NNeveur/MultiAntennaControler/AntHubRelayModule.pdf

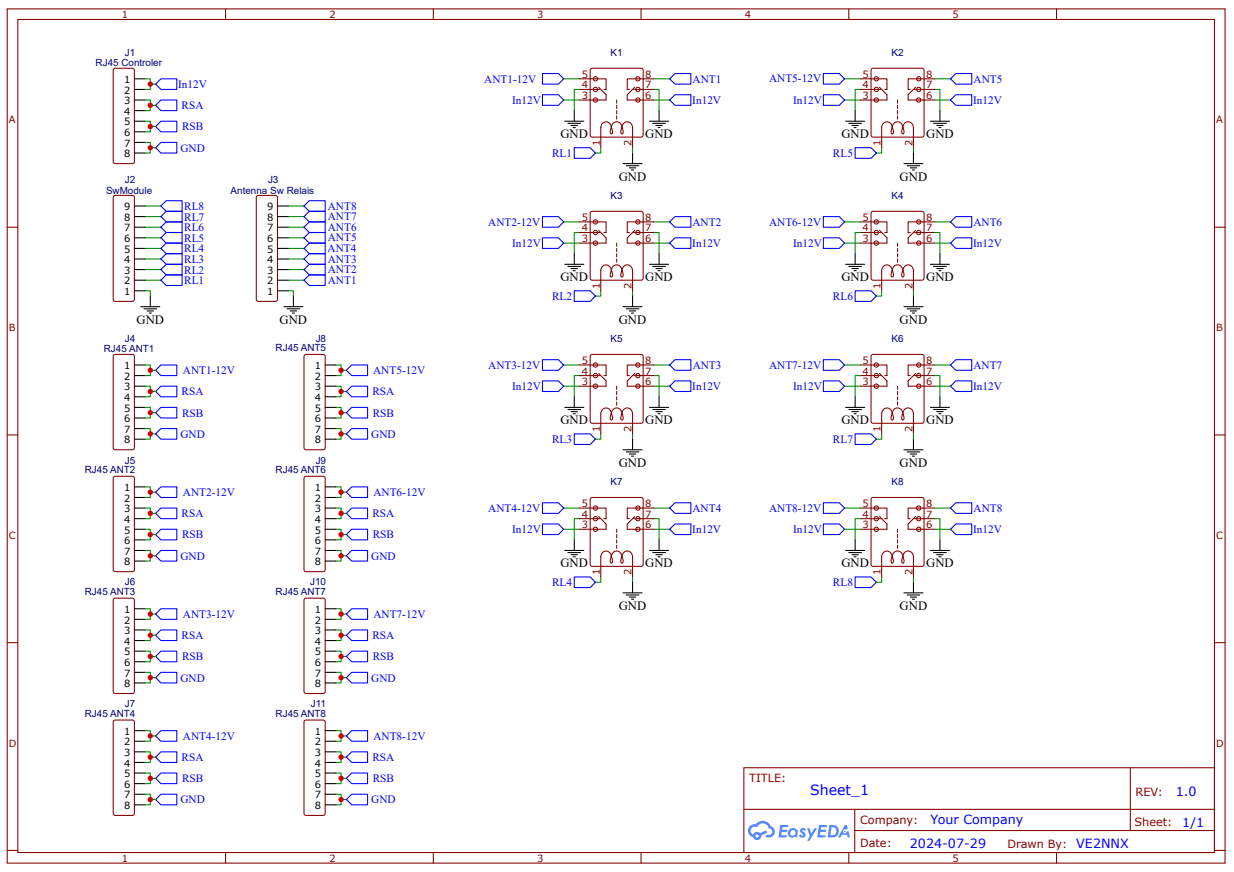
[picture p1: page 1]
TITLE:; REV: 1.0; Date:; Sheet:; awn By: VE; Company:; ole; GND; RSA; RSB; ANT1-12V; ANT2-12V; ANT3-12V; ANT4-12V; ANT8-12V; ANT7-12V; ANT6-12V; ANT5-12V; ule; ANT8; ANT7 ANT6 ANT5 ANT4 ANT3 ANT2 ANT1; elais; ANT1; ANT2; ANT3; ANT4; ANT7; ANT6; ANT5
