NNeveur/MultiAntennaControler/wheel.pdf

+5V | +5V

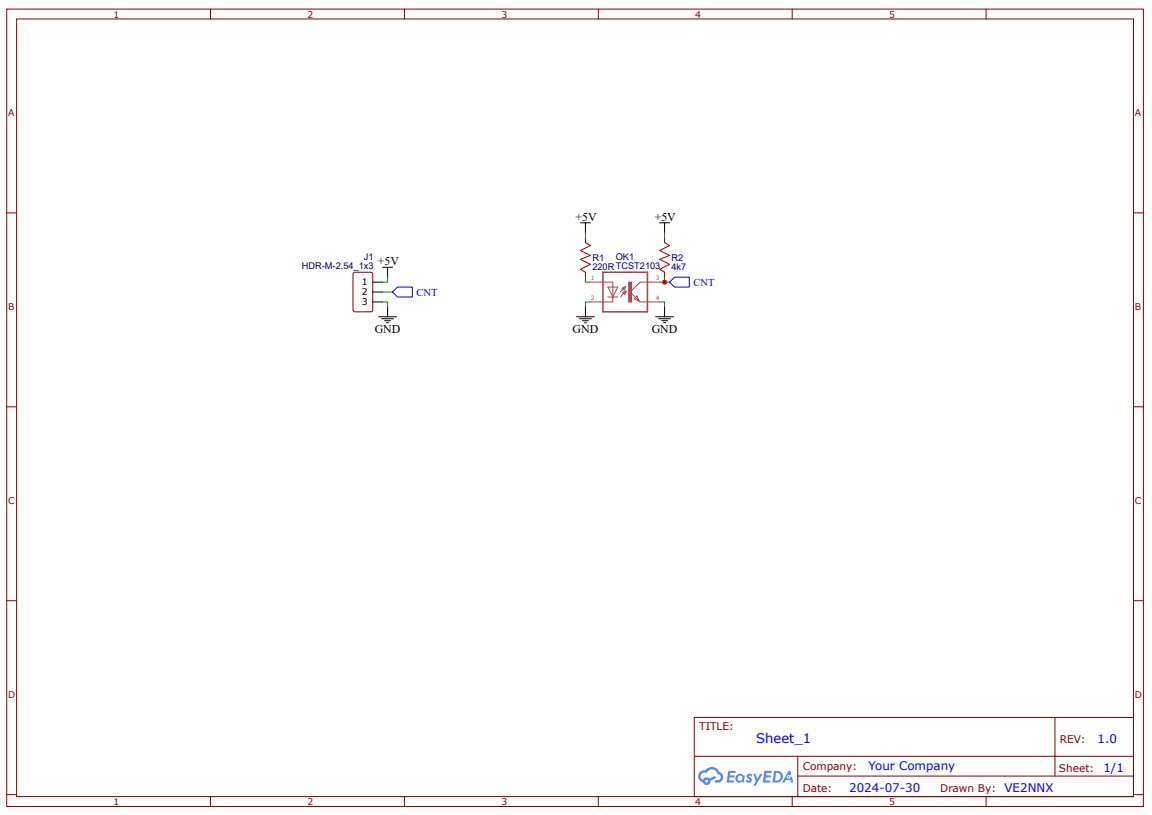
[picture p2: page 1]
TITLE:; Sheet_1; REV: 1.0; Date:; Sheet: 1/1; Drawn By: VE2NNX; TCST2103; GND; CNT; HDR-M-2.54_1x3

Company: Your Company
