NNeveur/MultiAntennaControler/MainCtrl.pdf

GND | GND | +5V

+3.3V

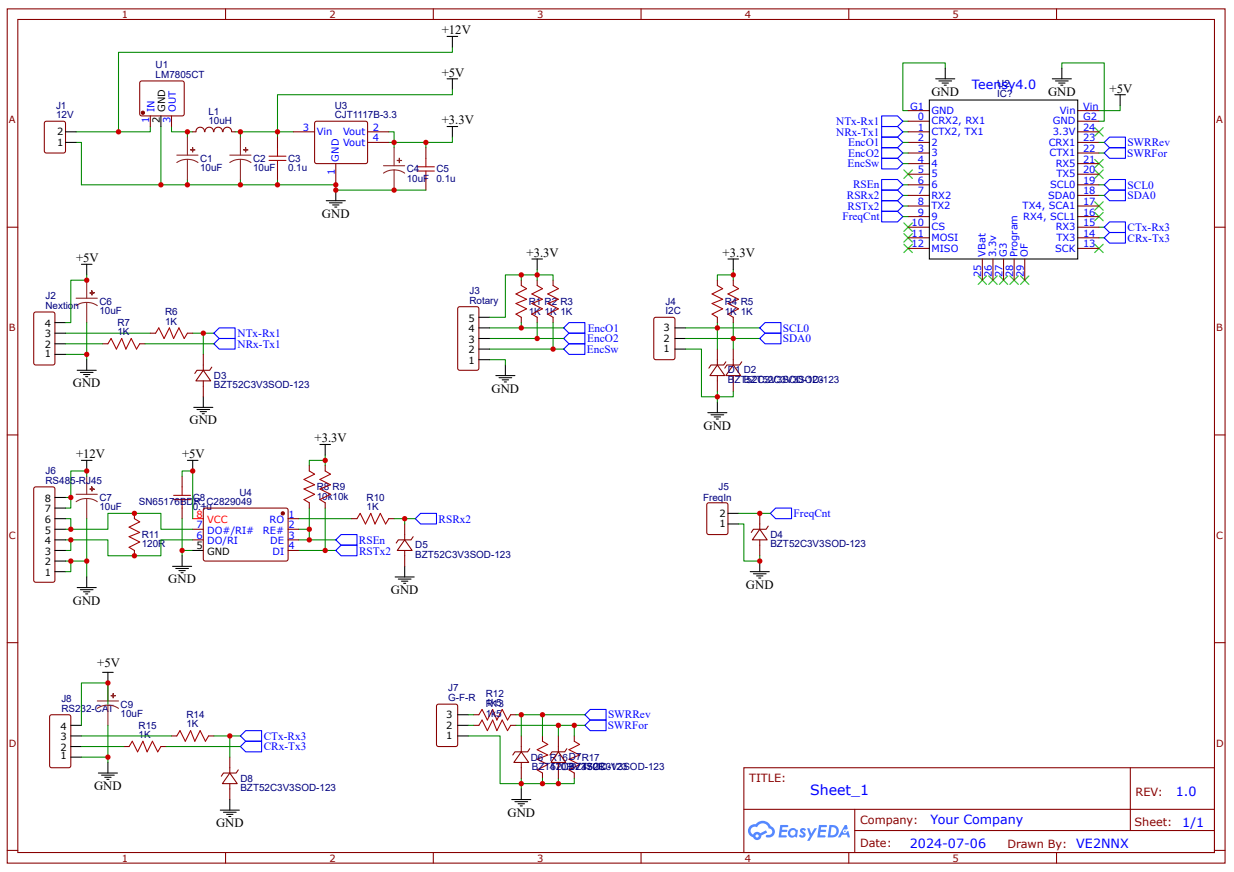
[picture p3: page 1]
