NNeveur/MultiAntennaControler/AntPoorStepModule.pdf

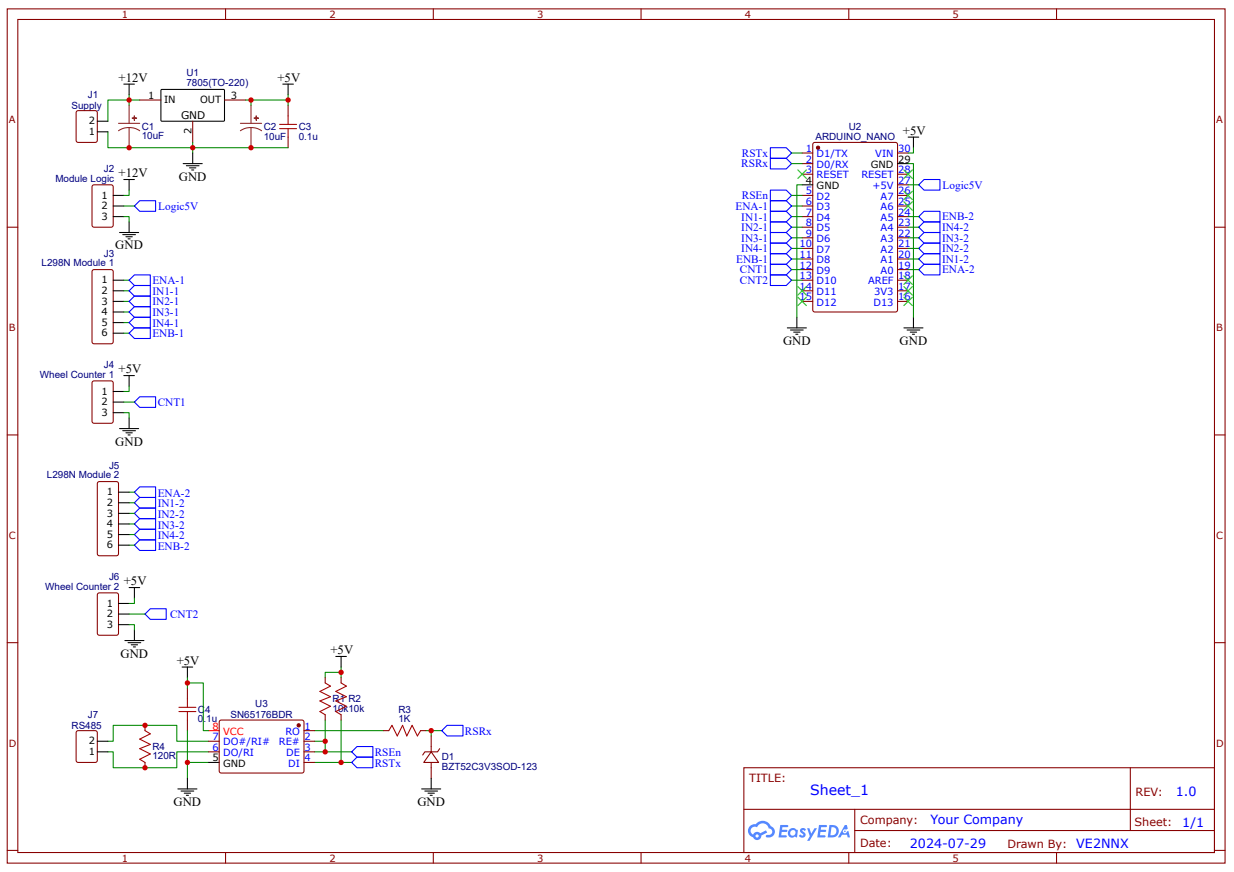
[picture p4: page 1]
