NNeveur/MultiAntennaControler/PCB_AntHubRelayModule.pdf

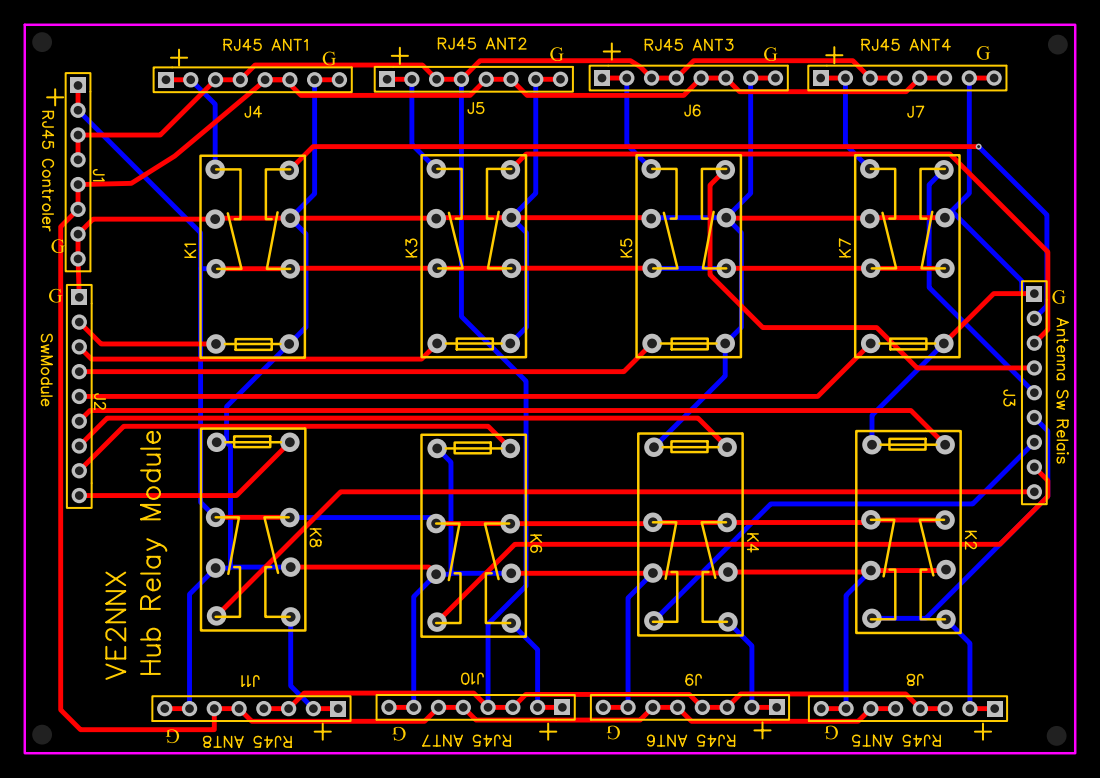
[picture p5: page 1]
