NNeveur/MultiAntennaControler/PCB_AntSwModule.pdf

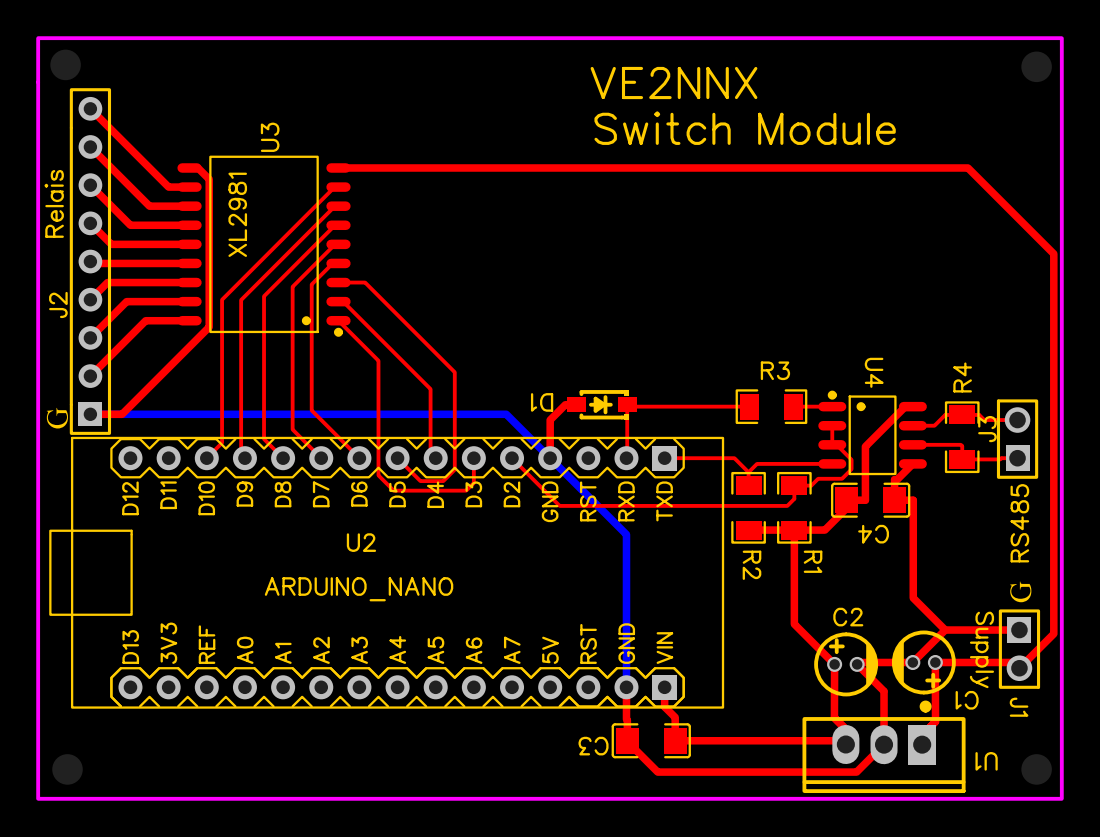
[picture p6: page 1]
