NNeveur/MultiAntennaControler/AntSwModule.pdf

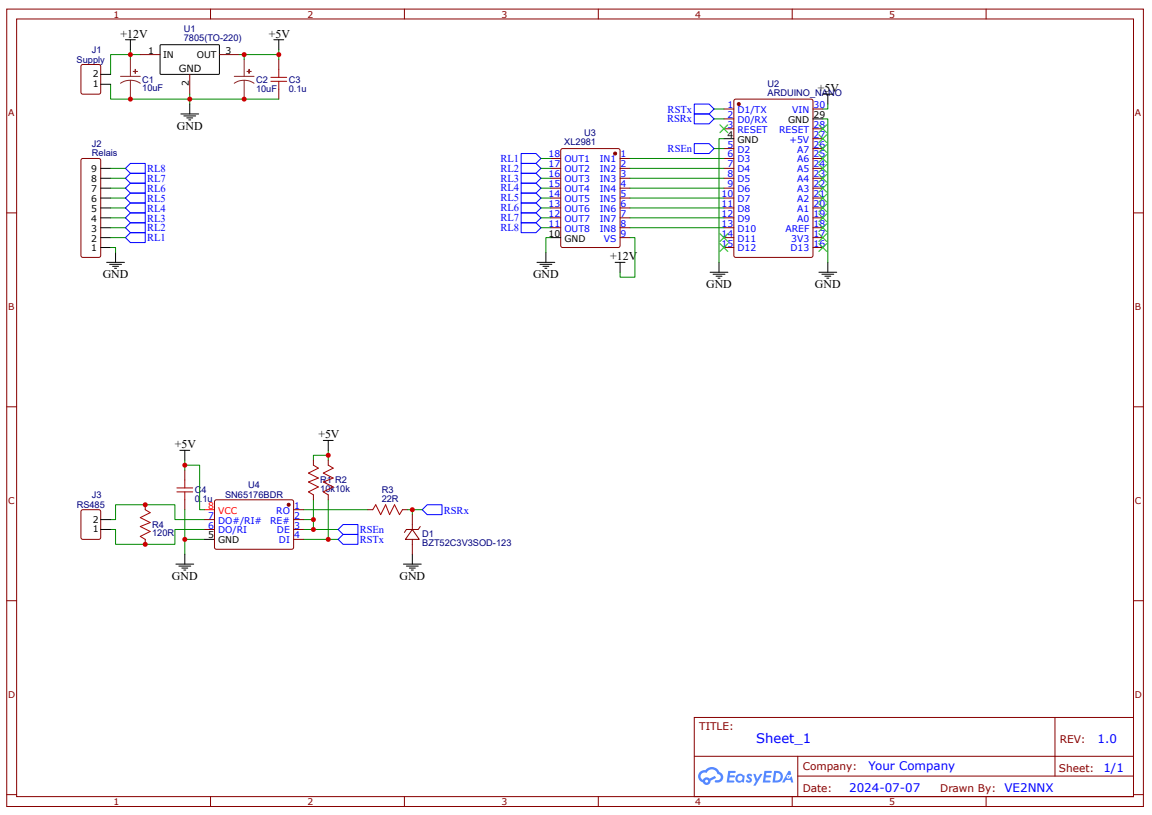
[picture p7: page 1]
