NNeveur/MultiAntennaControler/AntLoopModule.pdf

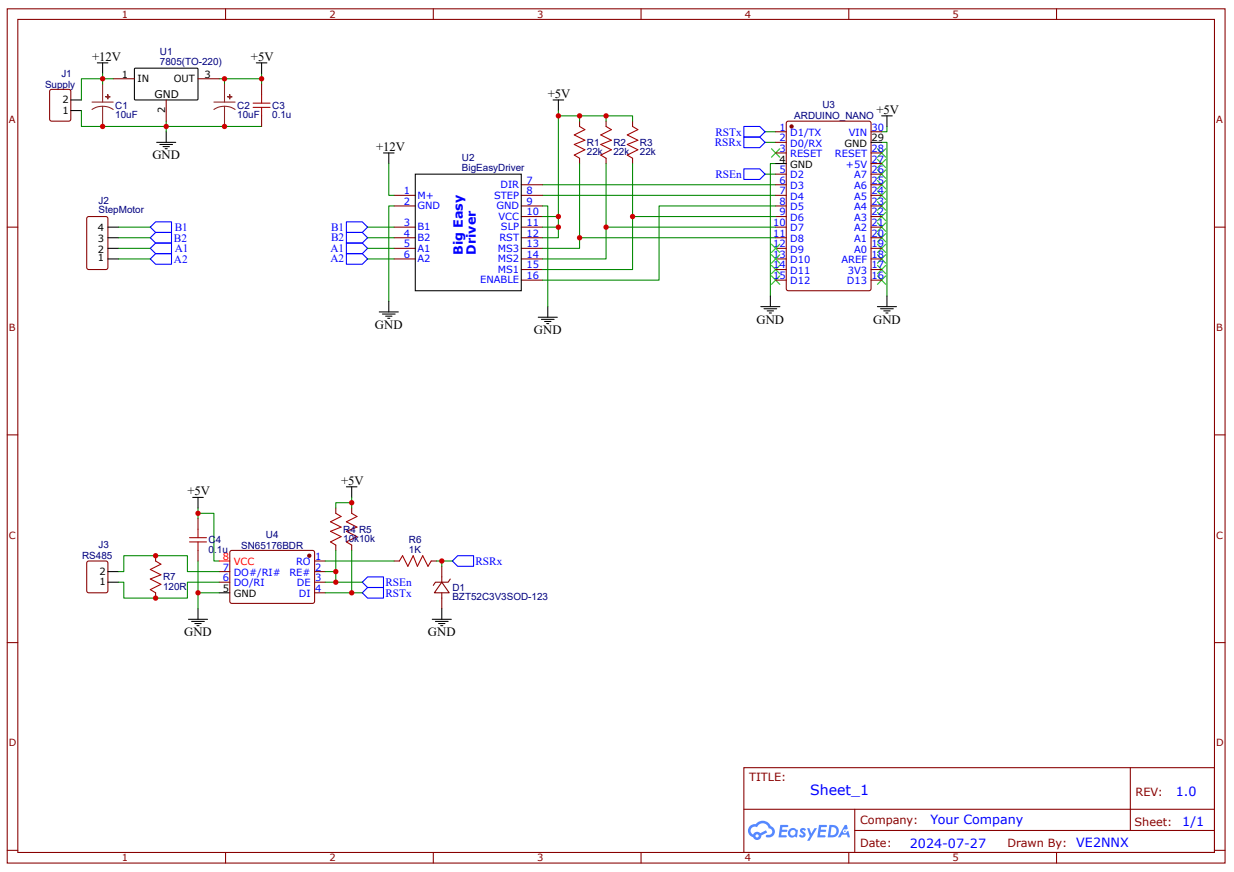
[picture p8: page 1]
